flo199213/APEROLiker/Documentation/Option_FootWithMagnets_11_02_2024.pdf

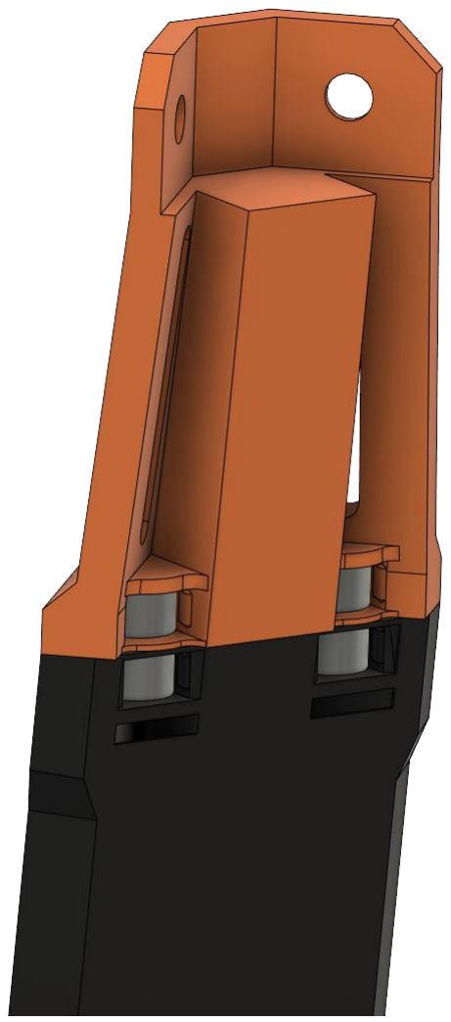
[picture p11: figure]

# MAGNET FOOT OPTION

# Version 11.02.2024

INTRODUCTION:
To prevent the plug-in extension feet from falling off when the APEROLiker is lifted, magnets can be inserted into the foot sections. These hold the plug-in connection securely and firmly in place.

INTRODUCTION | 3
PARTS LIST | 4
MAGNETIC FOOT ASSEMBLY .. | 9

# TABLE OF CONTENTS

FILE NAMING
By this time you should have already downloaded our STL/3MF files. You might have noticed that we have used a unique naming convention for the files. This is how to use them.

PRIMARY COLOR:
Example: ControlPanelRing.3mf
These files will have nothing at the start of the filename.

ACCENT COLOR:
Example: [a]_Controlpanel_Aperoliker.3mf
We have added “[a]” to the front of any STL file that is intended to be printed with accent color.

QUANTITY REQUIRED:
Example: [a]_Foot_x4.3mf
If any file ends with “_x#”, that is telling you the quantity of that part required to build the machine.

PART PRINTING GUIDELINES
We recommend you follow these Guidelines.

3D PRINTING PROCESS:
Fused Deposition Modeling (FDM)

MATERIAL:
PLA / ABS

LAYER HEIGHT:
Recommended: 0.2mm

EXTRUSION WIDTH:
Recommended: Forced 0.4mm

INFILL TYPE:
Gyroid

INFILL PERCENTAGE:
Recommended: 40%

WALL COUNT:
Recommended: 4

SOLID TOP/BOTTOM LAYERS:
Recommended: 5

SUPPORT AND MULTIMATERIAL:
Example: [MM]_HousingAperoliker.3mf
All files will print without support, if your 3D printer is well calibrated!

Except for the file of the housing. The "support structure above print bed" must be activated there!

In addition, you will notice the [MM]. The housing can be printed as a multi-material. No colour changer is necessary for this. See the chapter "Print housing multimaterial" for more information.

# INTRODUCTION

# PARTS LIST

You can source your parts from amazon, aliexpress, ebay or from your local parts store.

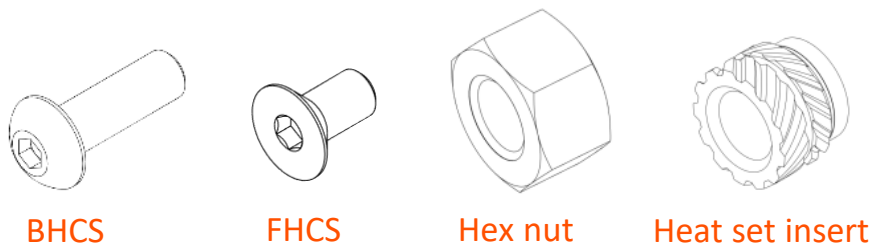
[picture p12: figure]
BHCS; FHCS; Hex nut; Heat set insert

Part | Quantity | Description | Part | Quantity | Description
Magnets 5x3mm | 16 | Special magnet foot option

# MAGNETIC FOOT ASSEMBLY

## Use a fast-acting glue, like super-glue

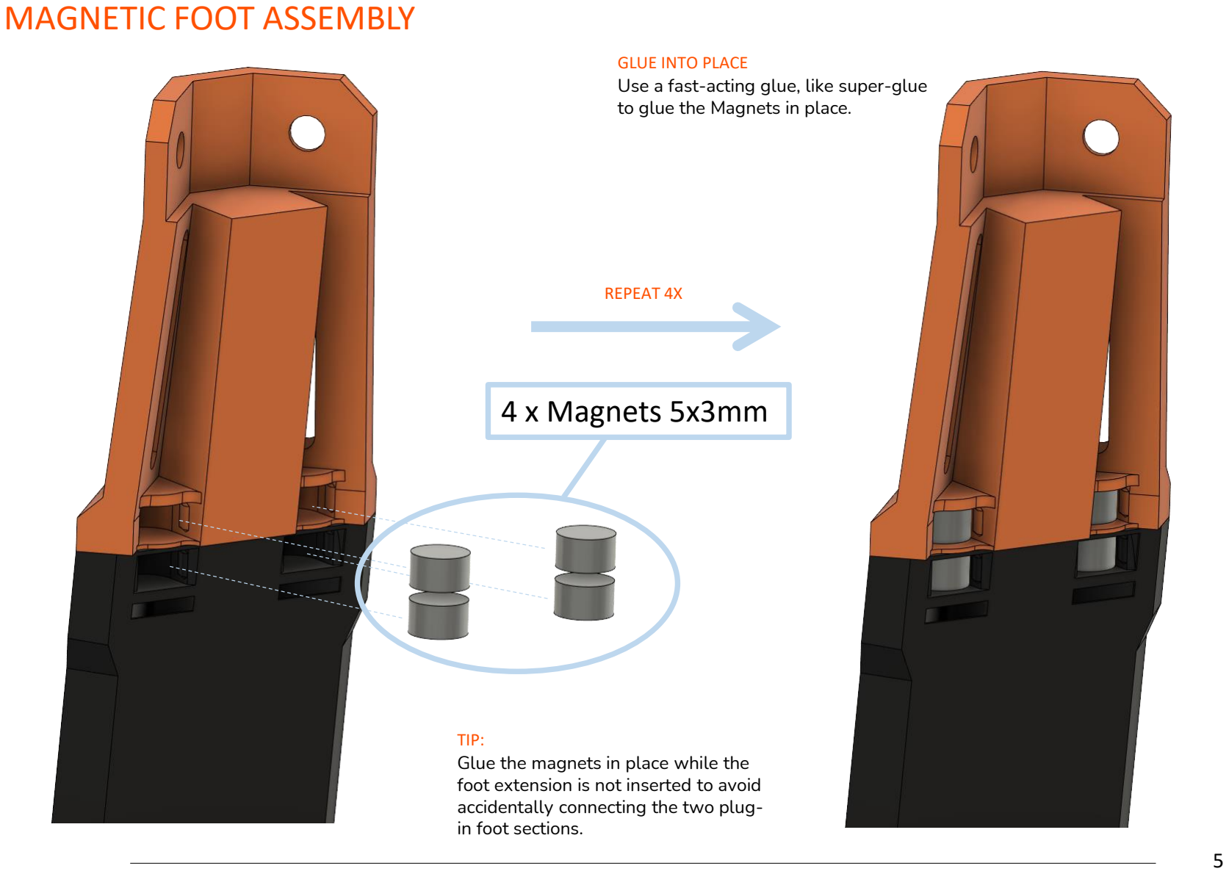
[picture p13: page 5]

# 4 x Magnets 5x3mm

GLUE INTO PLACE
to glue the Magnets in place.

REPEAT 4X

TIP:

## Glue the magnets in place while the foot extension is not inserted to avoid accidentally connecting the two plug-

in foot sections.

Enjoy your APEROLiker / HUGOliker.

### And please send the pictures of your build to: aperoliker.hugoliker@gmail.com ☺
