flo199213/APEROLiker/Documentation/Option_SPIFFSUploader_13_02_2024.pdf

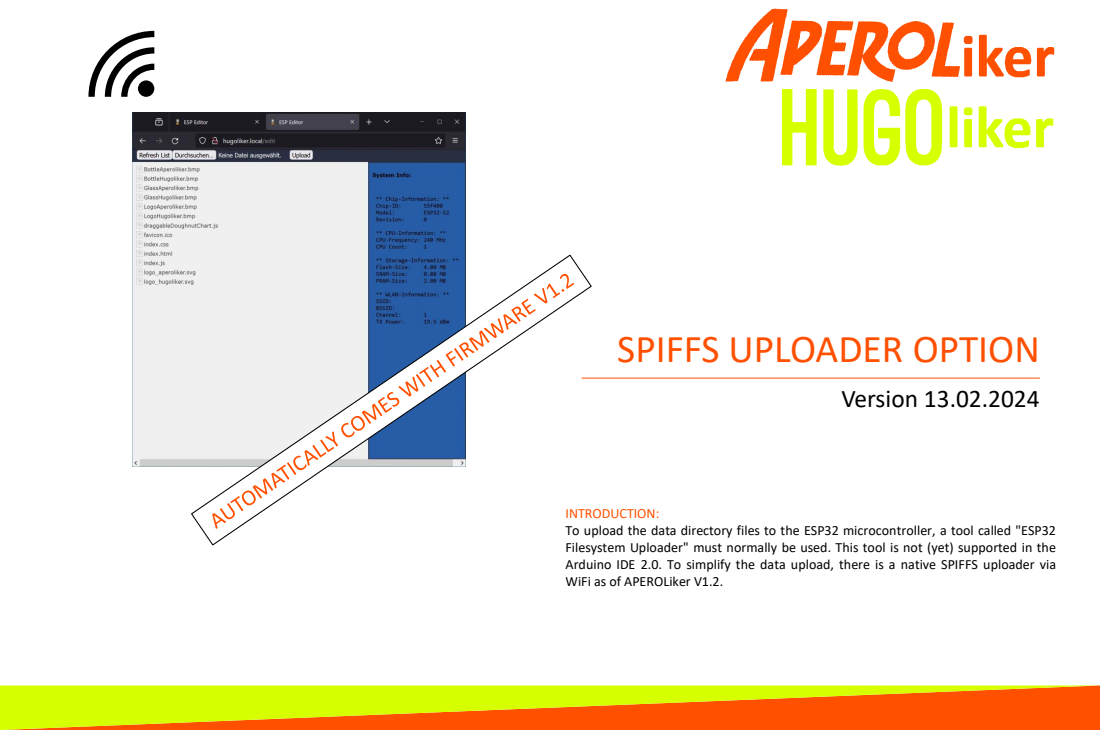
[picture p14: page 1]
Version 13.02.2024

SPIFFS UPLOADER OPTION

INTRODUCTION:
To upload the data directory files to the ESP32 microcontroller, a tool called "ESP32
Filesystem Uploader" must normally be used. This tool is not (yet) supported in the
Arduino IDE 2.0. To simplify the data upload, there is a native SPIFFS uploader via
WiFi as of APEROLiker V1.2.

## TABLE OF CONTENTS

## SPIFFS UPLOADER OPTION

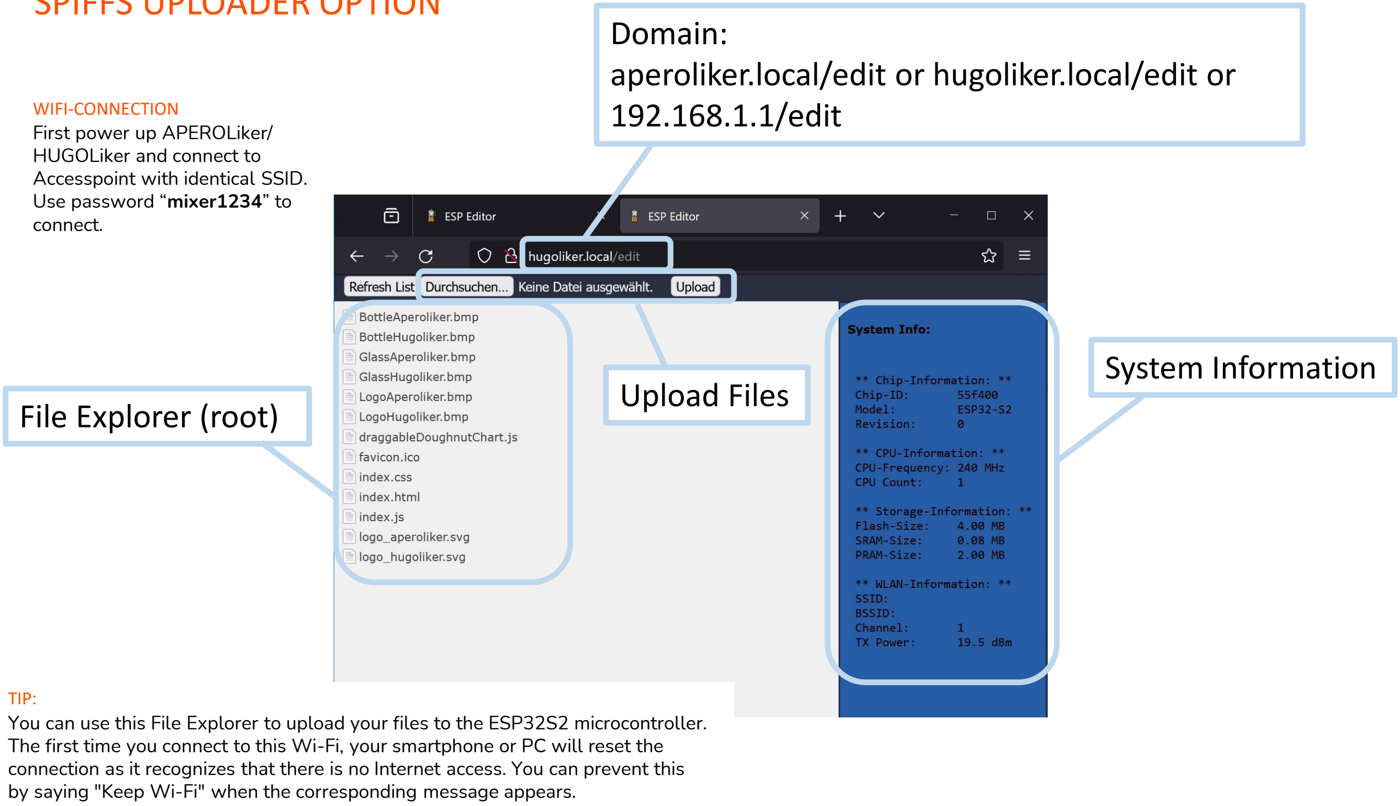
[picture p15: figure]
Domain:; 192.168.1.1/edit WIFI-CONNECTION First power up APEROLiker/ HUGOLiker and connect to Accesspoint with identical SSID. Use password “mixer1234” to connect.; TIP:; System Information; File Explorer (root); Upload Files

## aperoliker.local/edit or hugoliker.local/edit or

You can use this File Explorer to upload your files to the ESP32S2 microcontroller. The first time you connect to this Wi-Fi, your smartphone or PC will reset the connection as it recognizes that there is no Internet access. You can prevent this by saying "Keep Wi-Fi" when the corresponding message appears.

## WIFI CONTROL

## Domain:

WIFI-CONNECTION | aperoliker.local or hugoliker.local or 192.168.1.1
First power up APEROLiker/
HUGOLiker and connect to
Accesspoint with identical SSID.
Use password “mixer1234” to connect.

SIDE NOTE:

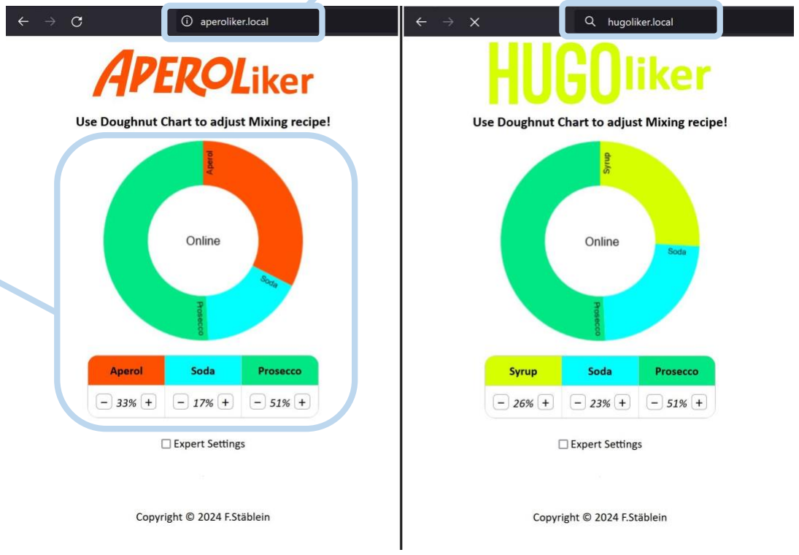
[picture p16: figure]

Do you realize that operating the APEROLiker/HUGOliker via WLAN is COMPLETELY over-engineered? But you can… because it was possible.

## Mixer Wifi Control

Enjoy your APEROLiker / HUGOliker.


And please send the pictures of your build to: aperoliker.hugoliker@gmail.com ☺
