flo199213/APEROLiker/Documentation/Schematic_Aperoliker_PCB_2024-01-11.pdf

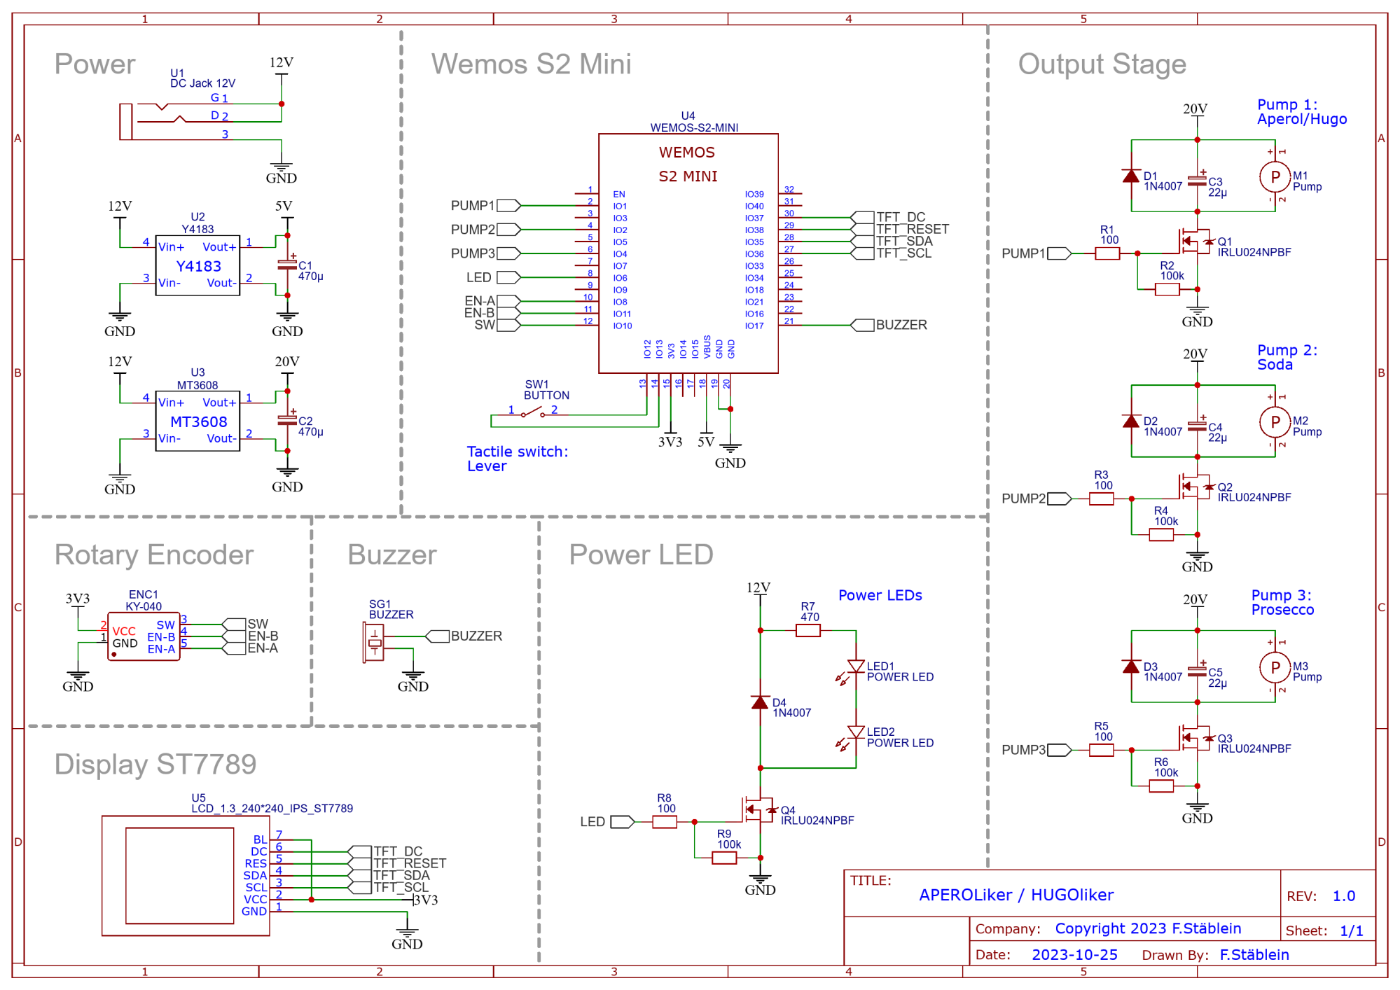
[picture p17: page 1]
