flo199213/APEROLiker/Images/Aperoliker_Page.JPG

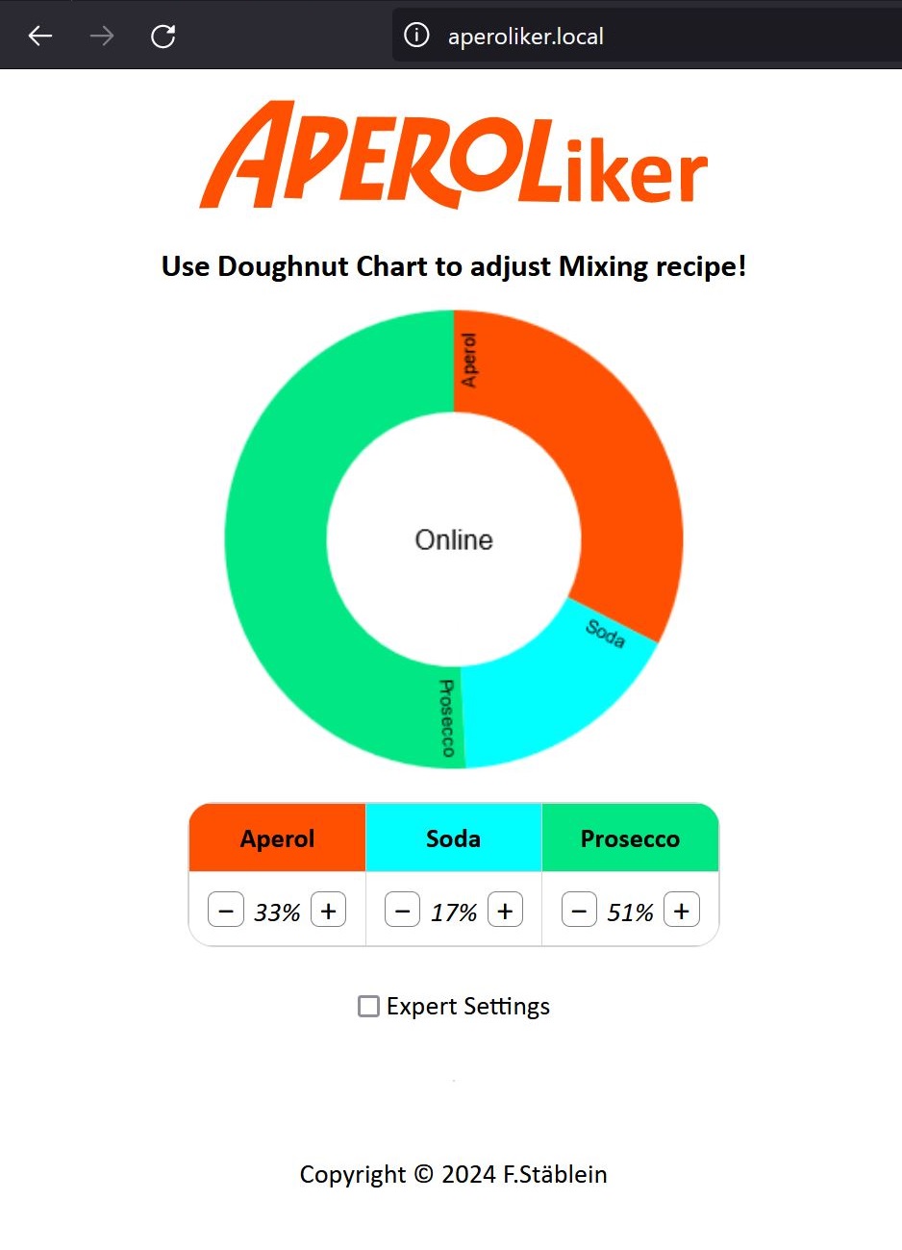
Images/Aperoliker_Page.JPG
