flo199213/APEROLiker/Images/Hugoliker_Page.JPG

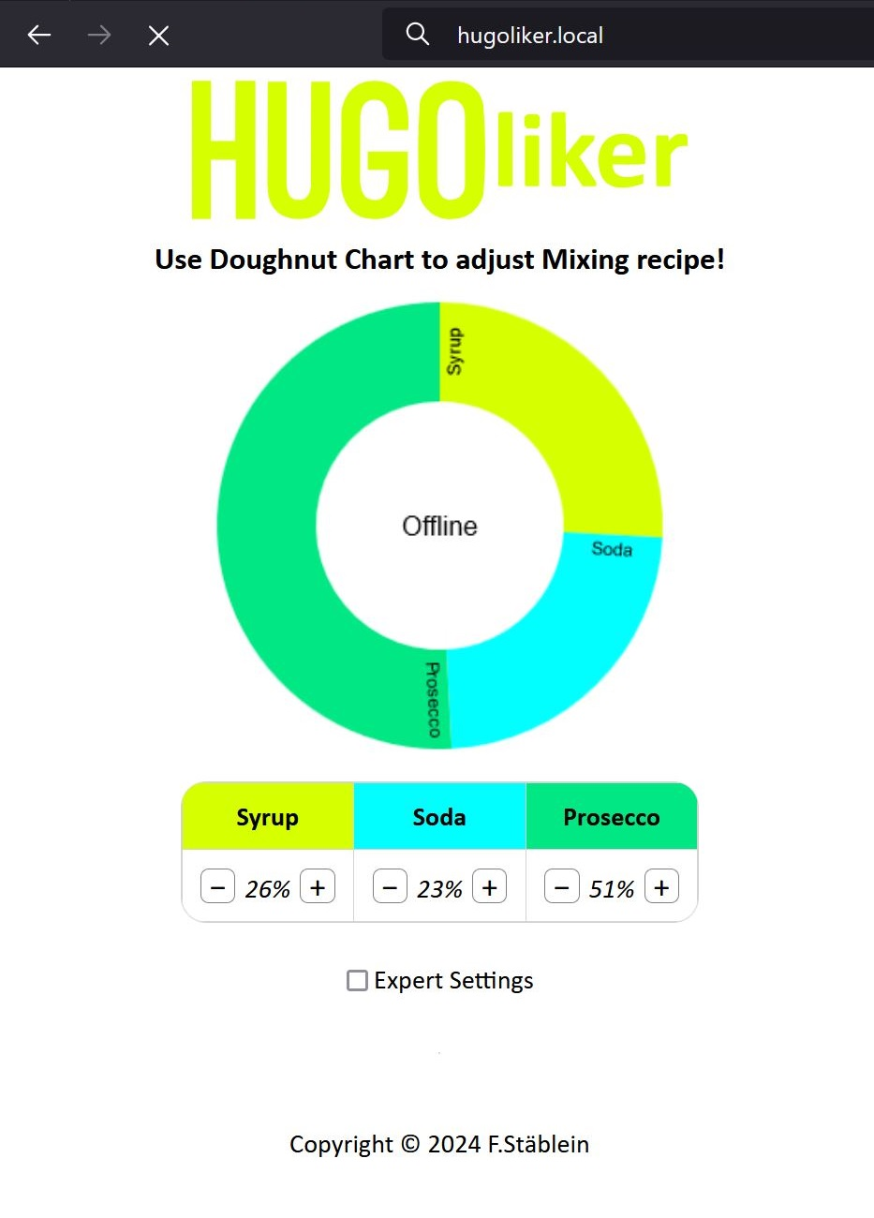
Images/Hugoliker_Page.JPG
