flo199213/APEROLiker/(list of files, drawings)

Other design files:
Documentation/SCH_Aperoliker_PCB_2024-01-20.json
