flo199213/APEROLiker/ESP32S2_WineBar_V1.2/StateMachine.cpp

/**
 * Includes all state machine functions
 *
 * @author    Florian Staeblein
 * @date      2024/01/28
 * @copyright © 2024 Florian Staeblein
 */

#include "StateMachine.h"

//===============================================================
// Global variables
//===============================================================
StateMachine Statemachine;

//===============================================================
// Constructor
//===============================================================
StateMachine::StateMachine()
{
}

//===============================================================
// Initializes the state machine
//===============================================================
void StateMachine::Begin(uint8_t pinBuzzer)
{
  // Save pin definitions
  _pinBuzzer = pinBuzzer;

  // Update all values
  UpdateValues();
}

//===============================================================
// Returns the current mixer state of the state machine
//===============================================================
MixerState StateMachine::GetCurrentState()
{
  return _currentState;
}

//===============================================================
// General state machine execution function
//===============================================================
void StateMachine::Execute(MixerEvent event)
{
  switch (_currentState)
  {
    case eMenu:
      FctMenu(event);
      break;
    case eCleaning:
      FctCleaning(event);
      break;
    case eBar:
      FctBar(event);
      break;
    case eSettings:
      FctSettings(event);
      break;
    case eScreenSaver:
      FctScreenSaver(event);
      break;
    default:  // In case something went wrong, default case is dashboard
    case eDashboard:
      FctDashboard(event);
      break;
  }
}

//===============================================================
// Function menu state
//===============================================================
void StateMachine::FctMenu(MixerEvent event)
{
  switch (event)
  {
    case eEntry:
      {
        // Update display and pump values
        UpdateValues();

        // Show menu page
        Serial.println("[MAIN] Enter Menu Mode");
        Display.ShowMenuPage();

        // Debounce page change
        delay(500);

        // Reset and ignore user input
        EncoderButton.GetEncoderIncrements();
        EncoderButton.IsButtonPress();
      }
      break;
    case eMain:
      {
        // Read encoder increments (resets the counter value)
        int16_t currentEncoderIncrements = EncoderButton.GetEncoderIncrements();

        // Check for changed encoder value
        if (currentEncoderIncrements != 0)
        {
          // Increment or decrement current menu state
          switch (_currentMenuState)
          {
            case eDashboard:
              _currentMenuState = currentEncoderIncrements > 0 ? eDashboard : eCleaning;
              break;
            case eCleaning:
              _currentMenuState = currentEncoderIncrements > 0 ? eDashboard : eBar;
              break;
            case eBar:
              _currentMenuState = currentEncoderIncrements > 0 ? eCleaning : eSettings;
              break;
            case eSettings:
              _currentMenuState = currentEncoderIncrements > 0 ? eBar : eSettings;
              break;
            default:
              break;
          }
            
          // Update display and pump values
          UpdateValues();

          // Update menu
          Display.DrawMenu();
        }

#if defined(WIFI_MIXER)
        // Draw wifi icons
        Display.DrawWifiIcons();
#endif

        // Check for button press
        if (EncoderButton.IsButtonPress())
        {
          // Short beep sound
          tone(_pinBuzzer, 500, 40);

          // Exit menu and enter new selected mode
          Execute(eExit);
          _currentState = _currentMenuState;
          Execute(eEntry);
          return;
        }
        
        // Check for screen saver timeout
        if (millis() - EncoderButton.GetLastUserAction() > SCREENSAVER_TIMEOUT_MS &&
          millis() - Pumps.GetLastUserAction() > SCREENSAVER_TIMEOUT_MS)
        {
          // Exit menu mode and enter screen saver mode
          Execute(eExit);
          _lastState = eMenu;
          _currentState = eScreenSaver;
          Execute(eEntry);
          return;
        }
      }
      break;
    case eExit:
    default:
      break;
  }
}

//===============================================================
// Function dashboard state
//===============================================================
void StateMachine::FctDashboard(MixerEvent event)
{
  switch(event)
  {
    case eEntry:
      {
        // If all three bottles are configured empty thats okay, because in this case the checkboxes will be displayed
        bool allEmpty = _barBottle1 == eEmpty && _barBottle2 == eEmpty && _barBottle3 == eEmpty;

        int16_t secureCounter = 0;
        switch (_dashboardLiquid)
        {
          case eLiquid1:
            if (_barBottle1 == eEmpty && !allEmpty)
            {
              // Skip empty bottle settings
              while (secureCounter++ < 3)
              {
                // Incrementing the setting value taking into account the overflow
                _dashboardLiquid = _dashboardLiquid + 1 >= (MixtureLiquid)MixtureLiquidDashboardMax ? eLiquid1 : (MixtureLiquid)(_dashboardLiquid + 1);

                // Break only if current bottle is not empty
                switch (_dashboardLiquid)
                {
                  case eLiquid1:
                    if (_barBottle1 != eEmpty) { secureCounter = 3; }
                    break;
                  case eLiquid2:
                    if (_barBottle2 != eEmpty) { secureCounter = 3; }
                    break;
                  case eLiquid3:
                    if (_barBottle3 != eEmpty) { secureCounter = 3; }
                    break;
                  default:
                    secureCounter = 3;
                    break;
                }
              }
            }
            break;
          case eLiquid2:
            if (_barBottle2 == eEmpty && !allEmpty)
            {
              // Skip empty bottle settings
              while (secureCounter++ < 3)
              {
                // Incrementing the setting value taking into account the overflow
                _dashboardLiquid = _dashboardLiquid + 1 >= (MixtureLiquid)MixtureLiquidDashboardMax ? eLiquid1 : (MixtureLiquid)(_dashboardLiquid + 1);
                
                // Break only if current bottle is not empty
                switch (_dashboardLiquid)
                {
                  case eLiquid1:
                    if (_barBottle1 != eEmpty) { secureCounter = 3; }
                    break;
                  case eLiquid2:
                    if (_barBottle2 != eEmpty) { secureCounter = 3; }
                    break;
                  case eLiquid3:
                    if (_barBottle3 != eEmpty) { secureCounter = 3; }
                    break;
                  default:
                    secureCounter = 3;
                    break;
                }
              }
            }
            break;
          case eLiquid3:
            if (_barBottle3 == eEmpty && !allEmpty)
            {
              // Skip empty bottle settings
              while (secureCounter++ < 3)
              {
                // Incrementing the setting value taking into account the overflow
                _dashboardLiquid = _dashboardLiquid + 1 >= (MixtureLiquid)MixtureLiquidDashboardMax ? eLiquid1 : (MixtureLiquid)(_dashboardLiquid + 1);
                
                // Break only if current bottle is not empty
                switch (_dashboardLiquid)
                {
                  case eLiquid1:
                    if (_barBottle1 != eEmpty) { secureCounter = 3; }
                    break;
                  case eLiquid2:
                    if (_barBottle2 != eEmpty) { secureCounter = 3; }
                    break;
                  case eLiquid3:
                    if (_barBottle3 != eEmpty) { secureCounter = 3; }
                    break;
                  default:
                    secureCounter = 3;
                    break;
                }
              }
            }
            break;
          default:
            break;
        }

        // Update display and pump values
        UpdateValues();

        // Show dashboard page
        Serial.println("[MAIN] Enter Dashboard Mode");
        Display.ShowDashboardPage();

        // Debounce page change
        delay(500);

        // Reset and ignore user input
        EncoderButton.GetEncoderIncrements();
        EncoderButton.IsLongButtonPress();
        EncoderButton.IsButtonPress();
      }
      break;
    case eMain:
      {
        // Read encoder increments (resets the counter value)
        int16_t currentEncoderIncrements = EncoderButton.GetEncoderIncrements();

        // Will be true, if new encoder position is available
        if (currentEncoderIncrements != 0)
        {
          // Increment or decrement current setting value
          switch (_dashboardLiquid)
          {
            case eLiquid1:
              _liquid1_Percentage = max(min(_liquid1_Percentage + currentEncoderIncrements, 95), 0);
              break;
            case eLiquid2:
              _liquid2_Percentage = max(min(_liquid2_Percentage + currentEncoderIncrements, 95), 0);
              break;
            case eLiquid3:
              _liquid3_Percentage = max(min(_liquid3_Percentage + currentEncoderIncrements, 95), 0);
              break;
            default:
              break;
          }
          
          // Update display and pump values
          UpdateValues();
          
          // Draw bar
          Display.DrawBar(true);
        }

#if defined(WIFI_MIXER)
        // Draw wifi icons
        Display.DrawWifiIcons();
#endif

        // Check for button press
        if (EncoderButton.IsButtonPress())
        {
          // Short beep sound
          tone(_pinBuzzer, 500, 40);

          // Skip empty bottle settings
          int16_t secureCounter = 0;
          do
          {
            // Incrementing the setting value taking into account the overflow
            _dashboardLiquid = _dashboardLiquid + 1 >= (MixtureLiquid)MixtureLiquidDashboardMax ? eLiquid1 : (MixtureLiquid)(_dashboardLiquid + 1);

            // If all three bottles are configured empty thats okay, because in this case the checkboxes will be displayed
            if (_barBottle1 == eEmpty && _barBottle2 == eEmpty && _barBottle3 == eEmpty)
            {
              break;
            }

            // Break only if current bottle is not empty
            switch (_dashboardLiquid)
            {
              case eLiquid1:
                if (_barBottle1 != eEmpty) { secureCounter = 3; }
                break;
              case eLiquid2:
                if (_barBottle2 != eEmpty) { secureCounter = 3; }
                break;
              case eLiquid3:
                if (_barBottle3 != eEmpty) { secureCounter = 3; }
                break;
              default:
                secureCounter = 3;
                break;
            }
          }
          while (secureCounter++ < 3);
          
          // Update all values
          UpdateValues();
          
          // Draw bar
          Display.DrawBar(true);
          
          // Debounce settings change
          delay(200);
        }

        // Check for long button press
        if (EncoderButton.IsLongButtonPress())
        {
          // Short beep sound
          tone(_pinBuzzer, 800, 40);

          // Exit dashboard and enter menu mode
          Execute(eExit);
          _currentState = eMenu;
          _currentMenuState = eDashboard;
          Execute(eEntry);
          return;
        }

        // Check for screen saver timeout
        if (millis() - EncoderButton.GetLastUserAction() > SCREENSAVER_TIMEOUT_MS &&
          millis() - Pumps.GetLastUserAction() > SCREENSAVER_TIMEOUT_MS)
        {
          // Exit dashboard mode and enter screen saver mode
          Execute(eExit);
          _lastState = eDashboard;
          _currentState = eScreenSaver;
          Execute(eEntry);
          return;
        }
      }
      break;
    case eExit:
    default:
      break;
  }
}

//===============================================================
// Function cleaning state
//===============================================================
void StateMachine::FctCleaning(MixerEvent event)
{
  switch(event)
  {
    case eEntry:
      {
        // Update display and pump values
        UpdateValues();

        // Show cleaning page
        Serial.println("[MAIN] Enter Cleaning Mode");
        Display.ShowCleaningPage();

        // Debounce page change
        delay(500);

        // Reset and ignore user input
        EncoderButton.IsButtonPress();
        EncoderButton.IsLongButtonPress();
      }
      break;
    case eMain:
      {
        // Check for button press
        if (EncoderButton.IsButtonPress())
        {
          // Short beep sound
          tone(_pinBuzzer, 500, 40);
          
          // Incrementing the setting value taking into account the overflow
          _cleaningLiquid = _cleaningLiquid + 1 >= (MixtureLiquid)MixtureLiquidCleaningMax ? eLiquid1 : (MixtureLiquid)(_cleaningLiquid + 1);

          // Update display and pump values
          UpdateValues();

          // Draw checkboxes
          Display.DrawCheckBoxes(_cleaningLiquid);

          // Debounce settings change
          delay(200);
        }

#if defined(WIFI_MIXER)
        // Draw wifi icons
        Display.DrawWifiIcons();
#endif

        // Check for long button press
        if (EncoderButton.IsLongButtonPress())
        {
          // Short beep sound
          tone(_pinBuzzer, 800, 40);

          // Exit cleaning mode and return to menu mode
          Execute(eExit);
          _currentState = eMenu;
          _currentMenuState = eCleaning;
          Execute(eEntry);
          return;
        }
        
        // Check for screen saver timeout
        if (millis() - EncoderButton.GetLastUserAction() > SCREENSAVER_TIMEOUT_MS &&
          millis() - Pumps.GetLastUserAction() > SCREENSAVER_TIMEOUT_MS)
        {
          // Exit cleaning mode and enter screen saver mode
          Execute(eExit);
          _lastState = eCleaning;
          _currentState = eScreenSaver;
          Execute(eEntry);
          return;
        }
      }
      break;
    case eExit:
    default:
      break;
  }
}

//===============================================================
// Function bar state
//===============================================================
void StateMachine::FctBar(MixerEvent event)
{
  switch(event)
  {
    case eEntry:
      {        
        // Update all values
        UpdateValues();
        
        // Show bar page
        Serial.println("[MAIN] Enter Bar Mode");
        Display.ShowBarPage();

        // Debounce page change
        delay(500);

        // Reset and ignore user input
        EncoderButton.GetEncoderIncrements();
        EncoderButton.IsButtonPress();
        EncoderButton.IsLongButtonPress();
      }
      break;
    case eMain:
      {
        // Read encoder increments (resets the counter value)
        int16_t currentEncoderIncrements = EncoderButton.GetEncoderIncrements();

        // Will be true, if new encoder position is available
        if (currentEncoderIncrements != 0)
        {
          // Increment or decrement current setting value
          switch (_dashboardLiquid)
          {
            case eLiquid1:
              {
                bool hasAlreadySparklingWater = _barBottle2 == eSparklingWater || _barBottle3 == eSparklingWater;
                if (currentEncoderIncrements > 0)
                {
                  _barBottle1 = _barBottle1 + 1 >= (BarBottle)BarBottleMax ? (hasAlreadySparklingWater ? eEmpty : eSparklingWater) : (BarBottle)(_barBottle1 + 1);
                }
                else
                {
                  _barBottle1 = _barBottle1 - 1 < (hasAlreadySparklingWater ? eEmpty : eSparklingWater) ? (BarBottle)(BarBottleMax - 1) : (BarBottle)(_barBottle1 - 1);
                }
              }
              break;
            case eLiquid2:
              {
                bool hasAlreadySparklingWater = _barBottle1 == eSparklingWater || _barBottle3 == eSparklingWater;
                if (currentEncoderIncrements > 0)
                {
                  _barBottle2 = _barBottle2 + 1 >= (BarBottle)BarBottleMax ? (hasAlreadySparklingWater ? eEmpty : eSparklingWater) : (BarBottle)(_barBottle2 + 1);
                }
                else
                {
                  _barBottle2 = _barBottle2 - 1 < (hasAlreadySparklingWater ? eEmpty : eSparklingWater) ? (BarBottle)(BarBottleMax - 1) : (BarBottle)(_barBottle2 - 1);
                }
              }
              break;
            case eLiquid3:
              {
                bool hasAlreadySparklingWater = _barBottle1 == eSparklingWater || _barBottle2 == eSparklingWater;
                if (currentEncoderIncrements > 0)
                {
                  _barBottle3 = _barBottle3 + 1 >= (BarBottle)BarBottleMax ? (hasAlreadySparklingWater ? eEmpty : eSparklingWater) : (BarBottle)(_barBottle3 + 1);
                }
                else
                {
                  _barBottle3 = _barBottle3 - 1 < (hasAlreadySparklingWater ? eEmpty : eSparklingWater) ? (BarBottle)(BarBottleMax - 1) : (BarBottle)(_barBottle3 - 1);
                }
              }
              break;
            default:
              break;
          }

          // Short beep sound
          tone(_pinBuzzer, 500, 40);

          // Update display and pump values
          UpdateValues();
          
          // Draw bar
          Display.DrawBar(false);
          
          // Debounce settings change
          delay(200);
        }

#if defined(WIFI_MIXER)
        // Draw wifi icons
        Display.DrawWifiIcons();
#endif

        // Check for button press
        if (EncoderButton.IsButtonPress())
        {
          // Short beep sound
          tone(_pinBuzzer, 500, 40);

          // Incrementing the setting value taking into account the overflow
          _dashboardLiquid = _dashboardLiquid + 1 >= (MixtureLiquid)MixtureLiquidDashboardMax ? eLiquid1 : (MixtureLiquid)(_dashboardLiquid + 1);

          // Update all values
          UpdateValues();
          
          // Draw bar
          Display.DrawBar(false);
          
          // Debounce settings change
          delay(200);
        }

        // Check for long button press
        if (EncoderButton.IsLongButtonPress())
        {
          // Short beep sound
          tone(_pinBuzzer, 800, 40);

          // Exit bar mode and return to menu mode
          Execute(eExit);
          _currentState = eMenu;
          _currentMenuState = eBar;
          Execute(eEntry);
          return;
        }

        // Check for screen saver timeout
        if (millis() - EncoderButton.GetLastUserAction() > SCREENSAVER_TIMEOUT_MS &&
          millis() - Pumps.GetLastUserAction() > SCREENSAVER_TIMEOUT_MS)
        {
          // Exit bar mode and enter screen saver mode
          Execute(eExit);
          _lastState = eBar;
          _currentState = eScreenSaver;
          Execute(eEntry);
          return;
        }
      }
      break;
    case eExit:
    default:
      break;
  }
}

//===============================================================
// Function settings state
//===============================================================
void StateMachine::FctSettings(MixerEvent event)
{
  switch(event)
  {
    case eEntry:
      {
        // Update display and pump values
        UpdateValues();

        // Show settings page
        Serial.println("[MAIN] Enter Settings Mode");
        Display.ShowSettingsPage();
        
        // Debounce page change
        delay(500);

        // Reset and ignore user input
        EncoderButton.GetEncoderIncrements();
        EncoderButton.IsLongButtonPress(); 
        EncoderButton.IsButtonPress();
      }
      break;
    case eMain:
      {
        // Read encoder increments (resets the counter value)
        int16_t currentEncoderIncrements = EncoderButton.GetEncoderIncrements();

        // Will be true, if new encoder position is available
        if (currentEncoderIncrements != 0)
        {
          // Update cycle timespan
          Pumps.SetCycleTimespan(Pumps.GetCycleTimespan() + currentEncoderIncrements * 20);

          // Draw settings in partial update mode
          Display.DrawSettings();
        }

#if defined(WIFI_MIXER)
        // Check for short button press
        if (EncoderButton.IsButtonPress())
        {
          // Update wifi mode
          Wifihandler.SetWifiMode(Wifihandler.GetWifiMode() == WIFI_MODE_AP ? WIFI_MODE_NULL : WIFI_MODE_AP);

          // Short beep sound
          tone(_pinBuzzer, 500, 40);

          // Draw settings in partial update mode
          Display.DrawWifiIcons(true);
          Display.DrawSettings();
        }

        // Draw wifi icons
        Display.DrawWifiIcons();
#endif

        // Check for long button press
        if (EncoderButton.IsLongButtonPress())
        {
          // Short beep sound
          tone(_pinBuzzer, 800, 40);

          // Exit settings mode and return to menu mode
          Execute(eExit);
          _currentState = eMenu;
          _currentMenuState = eSettings;
          Execute(eEntry);
          return;
        }

        // Check for screen saver timeout
        if (millis() - EncoderButton.GetLastUserAction() > SCREENSAVER_TIMEOUT_MS &&
          millis() - Pumps.GetLastUserAction() > SCREENSAVER_TIMEOUT_MS)
        {
          // Exit settings mode and enter screen saver mode
          Execute(eExit);
          _lastState = eSettings;
          _currentState = eScreenSaver;
          Execute(eEntry);
          return;
        }
      }
      break;
    case eExit:
      {
#if defined(WIFI_MIXER)
        Wifihandler.Save();
#endif
        Pumps.Save();
      }
      break;
    default:
      break;
  }
}

//===============================================================
// Function screen saver state
//===============================================================
void StateMachine::FctScreenSaver(MixerEvent event)
{
  switch(event)
  {
    case eEntry:
      {
        // Update display and pump values
        UpdateValues();
        
        // Show page
        Serial.println("[MAIN] Enter Screen Saver Mode");
        Display.ShowScreenSaverPage();
        
        // Reset and ignore user input
        EncoderButton.GetEncoderIncrements();
        EncoderButton.IsLongButtonPress(); 
        EncoderButton.IsButtonPress();
      }
      break;
    case eMain:
      {
        // Draw screen saver
        Display.DrawScreenSaver();
        
        // Check for user input
        if (EncoderButton.GetEncoderIncrements() != 0 ||
          EncoderButton.IsLongButtonPress() ||
          EncoderButton.IsButtonPress() ||
          Pumps.IsEnabled())
        {
          // Exit screen saver mode and return to last mode
          Execute(eExit);
          _currentState = _lastState;
          Execute(eEntry);
          return;
        }
      }
      break;
    case eExit:
    default:
      break;
  }
}

//===============================================================
// Updates all values in display and pumps driver
//===============================================================
void StateMachine::UpdateValues()
{
  // Update display driver
  Display.SetMenuState(_currentMenuState);
  Display.SetDashboardLiquid(_dashboardLiquid);
  Display.SetCleaningLiquid(_cleaningLiquid);
  Display.SetBar(_barBottle1, _barBottle2, _barBottle3);
  Display.SetPercentages(_liquid1_Percentage, _liquid2_Percentage, _liquid3_Percentage);

  bool hasSparklingWater = _barBottle1 == eSparklingWater || _barBottle2 == eSparklingWater || _barBottle3 == eSparklingWater;
  
  // Update pump driver
  switch (_currentState)
  {
    case eDashboard:
      {
        if (hasSparklingWater)
        {
          switch (_dashboardLiquid)
          {
            case eLiquid1:
              {
                double sparklingWaterPercetage = _liquid1_Percentage;
                double winePercetage = 100.0 - sparklingWaterPercetage;
                Pumps.SetPumps(winePercetage, _barBottle2 == eSparklingWater ? sparklingWaterPercetage : 0.0, _barBottle3 == eSparklingWater ? sparklingWaterPercetage : 0.0);
              }
              break;
            case eLiquid2:
              {
                double sparklingWaterPercetage = _liquid2_Percentage;
                double winePercetage = 100.0 - sparklingWaterPercetage;
                Pumps.SetPumps(_barBottle1 == eSparklingWater ? sparklingWaterPercetage : 0.0, winePercetage, _barBottle3 == eSparklingWater ? sparklingWaterPercetage : 0.0);
              }
              break;
            case eLiquid3:
              {
                double sparklingWaterPercetage = _liquid3_Percentage;
                double winePercetage = 100.0 - sparklingWaterPercetage;
                Pumps.SetPumps(_barBottle1 == eSparklingWater ? sparklingWaterPercetage : 0.0, _barBottle2 == eSparklingWater ? sparklingWaterPercetage : 0.0, winePercetage);
              }
              break;
            default:
              break;
          }
        }
        else
        {
          double dashboardLiquid1 = _dashboardLiquid == eLiquid1 ? 100.0 : 0.0;
          double dashboardLiquid2 = _dashboardLiquid == eLiquid2 ? 100.0 : 0.0;
          double dashboardLiquid3 = _dashboardLiquid == eLiquid3 ? 100.0 : 0.0;
          Pumps.SetPumps(dashboardLiquid1, dashboardLiquid2, dashboardLiquid3);
        }
      }
      break;
    case eCleaning:
      {
        double cleaningLiquid1 = _cleaningLiquid == eLiquidAll || _cleaningLiquid == eLiquid1 ? 100.0 : 0.0;
        double cleaningLiquid2 = _cleaningLiquid == eLiquidAll || _cleaningLiquid == eLiquid2 ? 100.0 : 0.0;
        double cleaningLiquid3 = _cleaningLiquid == eLiquidAll || _cleaningLiquid == eLiquid3 ? 100.0 : 0.0;
        Pumps.SetPumps(cleaningLiquid1, cleaningLiquid2, cleaningLiquid3);
      }
      break;
    default:
    case eMenu:
    case eBar:
    case eSettings:
      {
        Pumps.SetPumps(false, false, false); // zero
      }
      break;
  }
}
