flo199213/APEROLiker/ESP32S2_WineBar_V1.2/PumpDriver.h

/**
 * Includes all pump functions
 *
 * @author    Florian Staeblein
 * @date      2024/01/28
 * @copyright © 2024 Florian Staeblein
 */
 
#ifndef PUMPDRIVER_H
#define PUMPDRIVER_H

//===============================================================
// Includes
//===============================================================
#include <Arduino.h>
#include "Config.h"
#include "FlowMeterDriver.h"


//===============================================================
// Defines
//===============================================================
#define DEFAULT_CYCLE_TIMESPAN_MS     (uint32_t)1000
#define MIN_CYCLE_TIMESPAN_MS         (uint32_t)200
#define MAX_CYCLE_TIMESPAN_MS         (uint32_t)1000

#define KEY_CYCLETIMESPAN_MS          "CycleTimespan" // Key name: Maximum string length is 15 bytes, excluding a zero terminator.


//===============================================================
// Class for handling pump driver functions
//===============================================================
class PumpDriver
{
  public:
    // Constructor
    PumpDriver();

    // Initializes the pump driver
    void Begin(uint8_t pinPump1, uint8_t pinPump2, uint8_t pinPump3);

    // Return the timestamp of the last user action
    uint32_t GetLastUserAction();
    
    // Load settings from flash
    void Load();

    // Save settings to flash
    void Save();

    // Enables pump output
    void IRAM_ATTR Enable();
    
    // Disables pump output
    void IRAM_ATTR Disable();

    // Return true, if the pumps are enabled. Otherwise false
    bool IsEnabled();

    // Sets pumps from percentage (0-100%)
    void SetPumps(double value1_Percentage, double value2_Percentage, double value3_Percentage);

    // Sets the cycle timespan in ms (200-1000ms)
    bool SetCycleTimespan(uint32_t value_ms);

    // Returns the current cycle timespan
    uint32_t GetCycleTimespan();
    
    // Should be called every < 50 ms
    void IRAM_ATTR Update();

  private:
    // Preferences variable
    Preferences _preferences;

    // Pin definitions
    uint8_t _pinPump1;
    uint8_t _pinPump2;
    uint8_t _pinPump3;

    // Timing values
    uint32_t _cycleTimespan_ms = DEFAULT_CYCLE_TIMESPAN_MS;
    bool _isPumpEnabled = false;
    uint32_t _pwmPump1_ms = 0;
    uint32_t _pwmPump2_ms = 0;
    uint32_t _pwmPump3_ms = 0;

    // Last variables for edge detection
    bool _lastEnablePump1 = false;
    bool _lastEnablePump2 = false;
    bool _lastEnablePump3 = false;
    uint32_t _lastPumpCycleStart_ms = 0;
    
    // Timestamp of last user action
    uint32_t _lastUserAction = 0;

    // Disables pump output (internal)
    void DisableInternal();
};


//===============================================================
// Global variables
//===============================================================
extern PumpDriver Pumps;

#endif
