flo199213/APEROLiker/ESP32S2_WineBar_V1.2/SPIFFSEditor.cpp

/**
 * Includes all spiffs editor functions
 *
 * @author    Florian Staeblein
 * @date      2024/01/28
 * @copyright © 2024 Florian Staeblein
 */

//===============================================================
// Includes
//=============================================================== 
#include "SPIFFSEditor.h"

//===============================================================
// Defines
//=============================================================== 
#define edit_html_gz_len              4249

//===============================================================
// https://mischianti.org/online-converter-file-to-cpp-gzip-byte-array-3/
// File: edit.html.gz, Size: 4249
//=============================================================== 
const uint8_t edit_html_gz[] PROGMEM =
{  
  0x1F, 0x8B, 0x08, 0x00, 0x00, 0x00, 0x00, 0x00, 0x00, 0x03, 0xCD, 0x5B, 0xEB, 0x5E, 0xDB, 0xC8, 
  0x92, 0xFF, 0xCE, 0x53, 0x74, 0x94, 0x9D, 0x41, 0x1E, 0x7C, 0xC3, 0x10, 0x86, 0x98, 0x4B, 0xC6, 
  0x36, 0xE6, 0x12, 0x08, 0x37, 0x9B, 0x24, 0x24, 0x27, 0xE7, 0xFC, 0xDA, 0x52, 0xDB, 0x56, 0x90, 
  0x25, 0x45, 0x6A, 0x63, 0x3B, 0x0C, 0x6F, 0xB3, 0x5F, 0xF6, 0x35, 0x76, 0x5F, 0x6C, 0xAB, 0xFA, 
  0xA2, 0x8B, 0x2D, 0x43, 0x92, 0x3D, 0x1F, 0x36, 0xCC, 0x04, 0xAB, 0xBB, 0xBA, 0xBA, 0xBA, 0x2E, 
  0xFF, 0xAA, 0x6A, 0x39, 0xBB, 0x2F, 0x4A, 0xA5, 0xEE, 0xD0, 0x89, 0x08, 0xFC, 0xC7, 0x87, 0x8C, 
  0x04, 0x2E, 0x75, 0x3C, 0x32, 0xE4, 0x23, 0x97, 0x44, 0xFE, 0x38, 0xB4, 0x18, 0xF1, 0xFB, 0x62, 
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
        request->hasParam("format"))
      {
        return true;
      }
      else if (request->hasParam("edit"))
      {
        request->_tempFile = SPIFFS.open(request->arg("edit"), "r");
        if (!request->_tempFile)
        {
          return false;
        }

        if (request->_tempFile.isDirectory())
        {
          request->_tempFile.close();
          return false;
        }
      }
      else if (request->hasParam("download"))
      {
        request->_tempFile = SPIFFS.open(request->arg("download"), "r");
        if (!request->_tempFile)
        {
          return false;
        }

        if (request->_tempFile.isDirectory())
        {
          request->_tempFile.close();
          return false;
        }
      }
      request->addInterestingHeader("If-Modified-Since");
      return true;
    }
    else if (request->method() == HTTP_POST)
    {
      return true;
    }
    else if(request->method() == HTTP_DELETE)
    {
      return true;
    }
  }
  return false;
}

//===============================================================
// Handles the request
//===============================================================
void SPIFFSEditor::handleRequest(AsyncWebServerRequest *request)
{
  if (request->method() == HTTP_GET)
  {
    if (request->hasParam("format"))
    {
      SPIFFS.format();
      request->send(200, "", "FORMAT: SPIFFS sucessfully formatted");
    }
    else if (request->hasParam("systeminfo"))
    {
      request->send(200, "", GetSystemInfoString());
    }
    else if (request->hasParam("list"))
    {
      String path = request->getParam("list")->value();
      
      // Open directory
      File dir = SPIFFS.open(path);
      
      path = String();
      String output = "[";

      // Open first file
      File entry = dir.openNextFile();

      // Iterate through all files
      while (entry)
      {
        if (output != "[")
        {
          output += ',';
        }
        output += "{\"type\":\"";
        output += "file";
        output += "\",\"name\":\"";
        output += String(entry.name());
        output += "\",\"size\":";
        output += String(entry.size());
        output += "}";

        entry = dir.openNextFile();
      }

      dir.close();

      output += "]";
      request->send(200, "application/json", output);
      output = String();
    }
    else if (request->hasParam("edit") ||
      request->hasParam("download"))
    {
      request->send(request->_tempFile, request->_tempFile.name(), String(), request->hasParam("download"));
    }
    else
    {
      const char * buildTime = __DATE__ " " __TIME__ " GMT";
      if (request->header("If-Modified-Since").equals(buildTime))
      {
        request->send(304);
      }
      else
      {
        AsyncWebServerResponse *response = request->beginResponse_P(200, "text/html", edit_html_gz, edit_html_gz_len);
        response->addHeader("Content-Encoding", "gzip");
        response->addHeader("Last-Modified", buildTime);
        request->send(response);
      }
    }
  }
  else if (request->method() == HTTP_DELETE)
  {
    // Check for path param
    if (!request->hasParam("path", true))
    {
      request->send(404, "", "DELETE: Error deleting file, path parameter missing");
      return;
    }

    if (!SPIFFS.remove(request->getParam("path", true)->value()))
    {
      request->send(404, "", "DELETE: Error deleting file, SPIFFS error");
      return;
    }

    request->send(200, "", "DELETE: " + request->getParam("path", true)->value());
  }
  else if (request->method() == HTTP_POST)
  {
    if (request->hasParam("data", true, true) &&
      SPIFFS.exists(request->getParam("data", true, true)->value()))
    {
      request->send(200, "", "UPLOAD: " + request->getParam("data", true, true)->value());
    }
    else
    {
      request->send(500, "", "UPLOAD: Error uploading file");
    }
  }
}

//===============================================================
// Handles the upload
//===============================================================
void SPIFFSEditor::handleUpload(AsyncWebServerRequest* request, const String& filename, size_t index, uint8_t* data, size_t len, bool final)
{
  if (!index)
  {
    request->_tempFile = SPIFFS.open(filename, "w");
    _startTime = millis();
  }
  if (request->_tempFile)
  {
    if (len)
    {
      request->_tempFile.write(data,len);
    }
    if (final)
    {
      request->_tempFile.close();
    }
  }
}
