flo199213/APEROLiker/ESP32S2_WineBar_V1.2/WifiHandler.cpp

/**
 * Includes all wifi functions
 *
 * @author    Florian Staeblein
 * @date      2024/01/28
 * @copyright © 2024 Florian Staeblein
 */

#include "WifiHandler.h"

#if defined(WIFI_MIXER)

//===============================================================
// Global variables
//===============================================================
WifiHandler Wifihandler;

//===============================================================
// Will be called if an web socket event occours
//===============================================================
void onWsEvent(AsyncWebSocket* server, AsyncWebSocketClient* client, AwsEventType type, void* arg, uint8_t* data, size_t len)
{
  Wifihandler.OnWebsocketEvent(server, client, type, arg, data, len);
}

//===============================================================
// Constructor
//===============================================================
WifiHandler::WifiHandler()
{
}

//===============================================================
// Initializes the wifi handler
//===============================================================
void WifiHandler::Begin()
{
  Load();
  SetWifiMode(_initWifiMode);
}

//===============================================================
// Load values from flash
//===============================================================
void WifiHandler::Load()
{
  if (_preferences.begin(SETTINGS_NAME, true))
  {
    _initWifiMode = _preferences.getBool(KEY_WIFIMODE, false) ? WIFI_MODE_AP : WIFI_MODE_NULL;
    _preferences.end();
  }
}

//===============================================================
// Save values to flash
//===============================================================
void WifiHandler::Save()
{
  if (_preferences.begin(SETTINGS_NAME, false))
  {
    _preferences.putBool(KEY_WIFIMODE, _wifiMode == WIFI_AP);
    _preferences.end();
  }
}

//===============================================================
// Returns the current wifi mode
//===============================================================
wifi_mode_t WifiHandler::GetWifiMode()
{
  return _wifiMode;
}

//===============================================================
// Sets the wifi mode
//===============================================================
void WifiHandler::SetWifiMode(wifi_mode_t mode)
{
  if (_wifiMode == mode)
  {
    return;
  }

  if (mode == WIFI_MODE_AP)
  {
    // Set internal wifi mode if success
    _wifiMode = StartWebServer() ? WIFI_MODE_AP : WIFI_MODE_NULL;
  }
  else
  {
    StopWebServer();
    
    // Set internal wifi mode
    _wifiMode = WIFI_MODE_NULL;
  }
}

//===============================================================
// Returns the amount of connected clients
//===============================================================
uint16_t WifiHandler::GetConnectedClients()
{
  return WiFi.softAPgetStationNum();
}

//===============================================================
// Updates the web server and clients
//===============================================================
void WifiHandler::Update()
{
  if (_websocket)
  {
    // Clean websocket clients
    _websocket->cleanupClients();
  }

  if (_webevents)
  {
    // Send alive signal every second
    if (millis() - _lastAlive_ms > 1000)
    {
      _webevents->send("", "ALIVE");
      _lastAlive_ms = millis();
    }
  }
}

//===============================================================
// Will be called if an web socket event occours
//===============================================================
void WifiHandler::OnWebsocketEvent(AsyncWebSocket* server, AsyncWebSocketClient* client, AwsEventType type, void* arg, uint8_t* data, size_t len)
{
  // Client connected
  if (type == WS_EVT_CONNECT)
  {
    // Send all static settings to mixer on websocket connect
    client->printf("Connected Client Number %u", (uint16_t)client->id());
    UpdateSettingsToClient(client);
    client->ping();
  }
  //else if (type == WS_EVT_DISCONNECT)
  //else if (type == WS_EVT_ERROR)
  //else if (type == WS_EVT_PONG)
  else if (type == WS_EVT_DATA)
  {
    AwsFrameInfo* info = (AwsFrameInfo*)arg;
    String msg = "";
    if (info->final &&
      info->index == 0 &&
      info->len == len)
    {
      // The whole message is in a single frame and we got all of it's data
      if (info->opcode == WS_TEXT)
      {
        for (size_t index = 0; index < info->len; index++)
        {
          msg += (char)data[index];
        }

        if (msg.startsWith("FULLUPDATE"))
        {
          // Send all static settings to mixer on websocket connect
          client->text("Valid Fullupdate received!");
          UpdateSettingsToClient(client);
          client->ping();
        }
      }
    }
  }
}

//===============================================================
// Starts the web server
//===============================================================
bool WifiHandler::StartWebServer()
{
  // Reset old webserver instances
  StopWebServer();

  IPAddress local_ip(192, 168, 1, 1);
  IPAddress gateway(192, 168, 1, 1);
  IPAddress subnet(255, 255, 255, 0);
  
  // Set wifi TX power
  WiFi.setTxPower(WIFI_POWER_19_5dBm);
  
  // Start access point
  WiFi.softAP(_ssid, _password);
  WiFi.softAPConfig(local_ip, gateway, subnet);
  delay(100);

  // Set up mDNS responder to mixer name, e.g. http://winebar.local
  String mdnsName = MIXER_NAME;
  mdnsName.toLowerCase();
  mdnsName.trim();
  MDNS.begin(mdnsName);

  // Create web server
  _webserver.reset(new AsyncWebServer(80));
  if (!_webserver)
  {
    return false;
  }

  // Create web socket
  _websocket.reset(new AsyncWebSocket("/websocket"));
  if (!_websocket)
  {
    return false;
  }

  // Create web events
  _webevents.reset(new AsyncEventSource("/events"));
  if (!_webevents)
  {
    return false;
  }
  
  // Add root URL handler to web server
  _webserver->on("/", HTTP_GET, [](AsyncWebServerRequest * request)
  {
    request->send(SPIFFS, "/index.html", "text/html");
  });

  // Add system info URL handler to web server
  _webserver->on("/systeminfo", HTTP_GET, [](AsyncWebServerRequest * request)
  {
    request->send(200, "text/plain", GetSystemInfoString());
  });

  // Add SPIFFS Handler to web server
  _webserver->addHandler(new SPIFFSEditor());

  // Add not found handler to web server
  _webserver->onNotFound([](AsyncWebServerRequest *request)
  {
    request->send(404, "text/plain", "Sorry, page not found! Go to 'http://" + String(MIXER_NAME) + ".local' or 'http://192.168.1.1/'");
  });

  // Add websocket handler to web server
  _websocket->onEvent(onWsEvent);
  _webserver->addHandler(_websocket.get());

  // Add event handler to web server
  _webserver->addHandler(_webevents.get());

  // Add static files handler to web server
  _webserver->serveStatic("/", SPIFFS, "/").setDefaultFile("index.html");
  
  // Start web server
  _webserver->begin();

  // Add service to MDNS
  MDNS.addService("http", "tcp", 80);

  return true;
}

//===============================================================
// Stops the web server
//===============================================================
void WifiHandler::StopWebServer()
{
  // End old web event instances
  if (_webevents)
  {
    _webevents->close();
    _webevents.reset();
  }

  // End old web socket instances
  if (_websocket)
  {
    _websocket->closeAll();
    _websocket.reset();
  }

  // End old web server instances
  if (_webserver)
  {
    _webserver->end();
    _webserver.reset();
  }

  // Deactivate Accesspoint and Wifi
  WiFi.softAPdisconnect(true);
}

//===============================================================
// Updates all settings in given client
//===============================================================
void WifiHandler::UpdateSettingsToClient(AsyncWebSocketClient* client)
{
  if (!client)
  {
    return;
  }

  client->printf("CLIENT_ID:%s", String(client->id()).c_str());
  client->printf("MIXER_NAME:%s", MIXER_NAME);
  client->printf("LIQUID_NAMES:%s,%s,%s", LIQUID1_NAME, LIQUID2_NAME, LIQUID3_NAME);
  client->printf("LIQUID_COLORS:%s,%s,%s", String(WIFI_COLOR_LIQUID_1).c_str(), String(WIFI_COLOR_LIQUID_2).c_str(), String(WIFI_COLOR_LIQUID_3).c_str());
}

#endif
