flo199213/APEROLiker/ESP32S2_WineBar_V1.2/WifiHandler.h

/**
 * Includes all wifi functions
 *
 * @author    Florian Staeblein
 * @date      2024/01/28
 * @copyright © 2024 Florian Staeblein
 */
 
#ifndef WIFIHANDLER_H
#define WIFIHANDLER_H

//===============================================================
// Includes
//===============================================================
#include <Arduino.h>
#include <Preferences.h>
#include <SPIFFS.h>
#include <WiFi.h>
#include <ESPmDNS.h>
#include <AsyncTCP.h>
#include <ESPAsyncWebServer.h>
#include <SPIFFSEditor.h>
#include "Config.h"
#include "StateMachine.h"


#if defined(WIFI_MIXER)

//===============================================================
// Defines
//===============================================================
#define KEY_WIFIMODE      "WifiMode"   // Key name: Maximum string length is 15 bytes, excluding a zero terminator.


//===============================================================
// Class for wifi handling
//===============================================================
class WifiHandler
{
  public:
    // Constructor
    WifiHandler();

    // Initializes the wifi handler
    void Begin();

    // Load values from flash
    void Load();

    // Save values to flash
    void Save();

    // Returns the current wifi mode
    wifi_mode_t GetWifiMode();

    // Sets the wifi mode
    void SetWifiMode(wifi_mode_t mode);

    // Returns the amount of connected clients
    uint16_t GetConnectedClients();

    // Updates the web server and clients
    void Update();

    // Will be called if an web socket event occours (only internal use)
    void OnWebsocketEvent(AsyncWebSocket* server, AsyncWebSocketClient* client, AwsEventType type, void* arg, uint8_t* data, size_t len);

  private:
    // Preferences variable
    Preferences _preferences;
    
    // Wifi settings
    wifi_mode_t _initWifiMode = WIFI_MODE_AP;
    wifi_mode_t _wifiMode = WIFI_MODE_NULL;

    // SSID and Password
    const char* _ssid = MIXER_NAME;
    const char* _password = "mixer1234";
    
    // Web server variables
    std::unique_ptr<AsyncWebServer> _webserver;
    std::unique_ptr<AsyncWebSocket> _websocket;
    std::unique_ptr<AsyncEventSource> _webevents;

    // Alive counter variable
    uint32_t _lastAlive_ms = 0;

    // Starts the web server
    bool StartWebServer();

    // Stops the web server
    void StopWebServer();

    // Updates all settings in given client
    void UpdateSettingsToClient(AsyncWebSocketClient* client);
};


//===============================================================
// Global variables
//===============================================================
extern WifiHandler Wifihandler;


#endif
#endif
