flo199213/APEROLiker/ESP32S2_WineBar_V1.2/SystemHelper.h

/**
 * Includes all system helper functions
 *
 * @author    Florian Staeblein
 * @date      2024/01/28
 * @copyright © 2024 Florian Staeblein
 */
 
#ifndef SYSTEMHELPER_H
#define SYSTEMHELPER_H

//===============================================================
// Inlcudes
//===============================================================
#include <Arduino.h>
#include <ESP.h>
#include <WiFi.h>
#include <SPIFFS.h>
#include "esp32s2/rom/rtc.h"

//===============================================================
// Returns the complete system info as string
//===============================================================
String GetSystemInfoString();

//===============================================================
// Returns memory info string
//===============================================================
String GetMemoryInfoString(bool allOrDynamic = false);

//===============================================================
// Returns a string for a wifi power
//===============================================================
String WifiPowerToString(wifi_power_t power);

//===============================================================
// Returns the reset reason as string
//===============================================================
String GetResetReasonString(int cpu);

#endif
