flo199213/APEROLiker/(commit log)

2024-01-20 FS: Added Pseudo Schematics
    [SCH_Aperoliker_PCB_2024-01-20.json]
2024-01-28 FS: BugFix in commented out optional code
    [PumpDriver.cpp]
2024-01-28 FS: Version V1.1 launched with major improvements
    [ESP32S2_Aperoliker_V1.1.partitions.csv, ESP32S2_Hugoliker_V1.1.partitions.csv]
2024-01-28 FS: Added build for V1.0
    [ESP32S2_Aperoliker_V1.0.partitions.csv, ESP32S2_Hugoliker_V1.0.partitions.csv]
2024-01-28 FS: Introduced selection of pumps in cleaning mode, added debouncing for button
2024-01-29 FS: Fixed display speed of the startpage graphics
    [DisplayDriver.cpp, DisplayDriver.h]
2024-02-08 FS: Release V1.2 launched (Wifi+Statemachine+SPIFFS Editor)
    [ESP32S2_Aperoliker_V1.2.partitions.csv, ESP32S2_Hugoliker_V1.2.partitions.csv]
2024-03-02 FS: Bugfix screen saver with wifi icons
    [StateMachine.cpp]
2024-03-03 FS: Added compiler-switch for building with or without Wifi, improved debug output
2024-03-03 FS: BugFix viewing screen saver, remaining pixels
    [DisplayDriver.cpp, SPIFFSImageReader.cpp, SPIFFSImageReader.h]
2024-03-11 FS: ISR BugFix, use IRAM_ATTR for saving flow values
    [ESP32S2_Aperoliker_V1.2.ino, ESP32S2_WineBar_V1.2.ino, FlowMeterDriver.cpp, FlowMeterDriver.h, PumpDriver.cpp, PumpDriver.h, WifiHandler.cpp, WifiHandler.h]
2024-12-27 FS: Added LED status and encoder direction define
2024-12-29 FS: Added voltage measurement for aperoliker PCB
2025-01-04 FS: Builds successfully with ESP-IDF 5.3 and Arduino IDE 2.3.4 (AsyncTCP and ESPAsyncWebServer from mathieucarbou)
2025-01-07 FS: Avoid rebooting device when disabling web server
    [WifiHandler.cpp, WifiHandler.h]
2025-01-07 FS: Flowrate definition per pump for calibration
